kingwooseok/Smart-Farming-Beyond-the-Greenhouse/archive/README.md

# 초기 통신 스케치

`last12_40/last12_40.ino`는 작업 폴더에 남아 있던 원본 파일입니다.

- A0에서 ADC 값을 읽고 0~99로 변환합니다.
- `[0x28, 센서값]`을 목적지 `0x21`로 전송합니다.
- 전송 주기는 `millis()` 기준 1,111 ms입니다.

최종 4개 노드 구성은 [`firmware/`](../firmware)에 있습니다. 원본 파일은 초기 TWI 송신 구현을 보존하기 위해 수정하지 않았습니다.
